lambebop/KiRA/README.md

# KiRA Flight Computer

Flight computer of Karlsruhe International Rocketry Association
