lambebop/KiRA/dep/Wio-SX1262 file.step

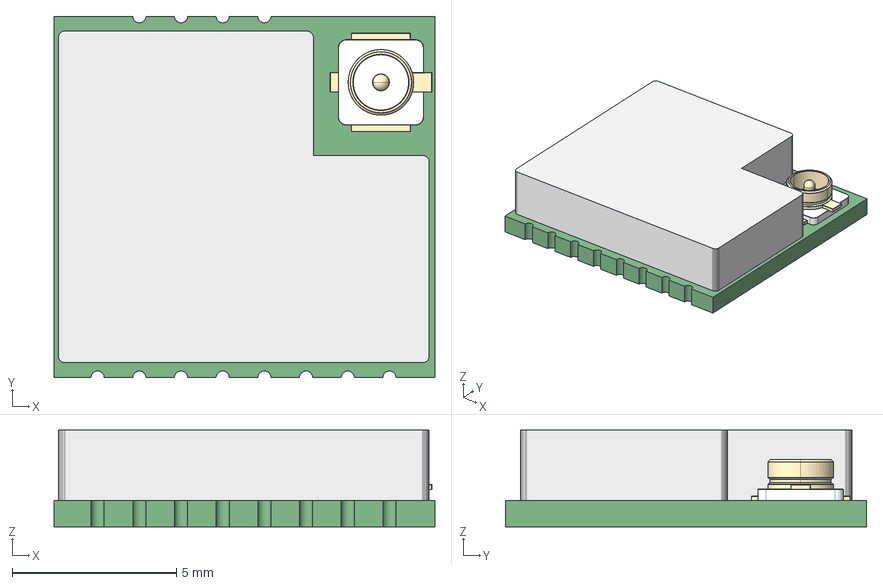
[picture p1: CAD file, 2025-10-07]
dep/Wio-SX1262 file.step
11.6 x 11.0 x 2.95 mm
User_Library-IPEX
Extruded
