lambebop/KiRA/dep/FDMA430NZ.stp

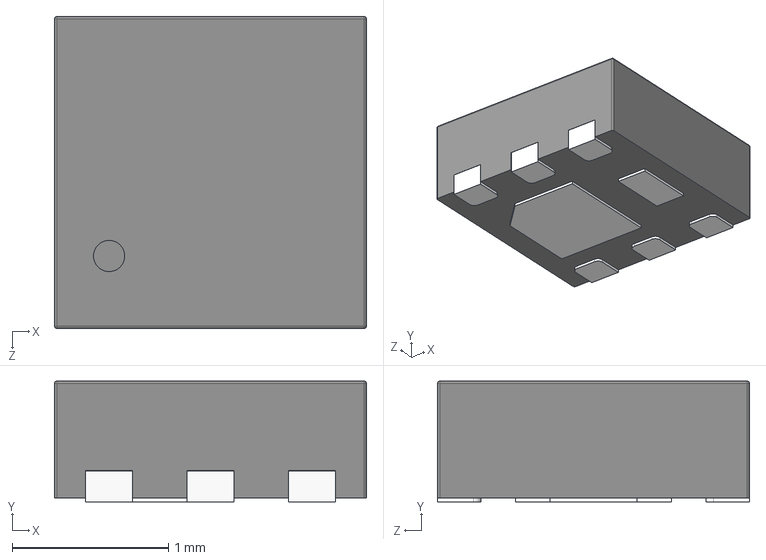
[picture p2: CAD file, 2025-10-07]
dep/FDMA430NZ.stp
2.00 x 0.775 x 2.00 mm
