lambebop/KiRA/dep/CONSMA001-SMD-G.stp

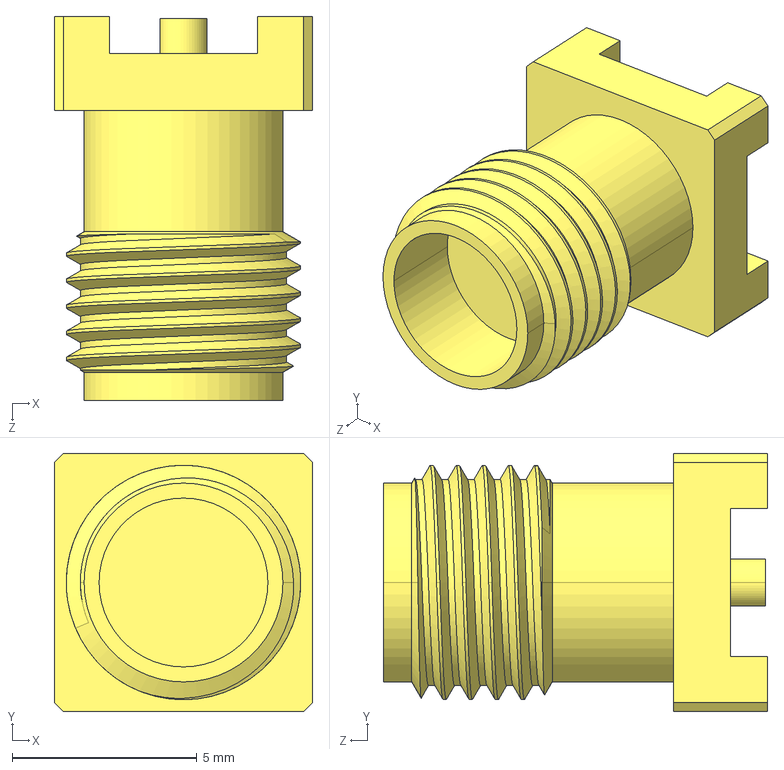
[picture p3: CAD file, 2025-10-07]
dep/CONSMA001-SMD-G.stp
7.00 x 7.00 x 10.4 mm
