lambebop/KiRA/KiRA Flight Computer.kicad_pcb

## KiCad design KiRA Flight Computer.kicad_pcb (2025-10-17)

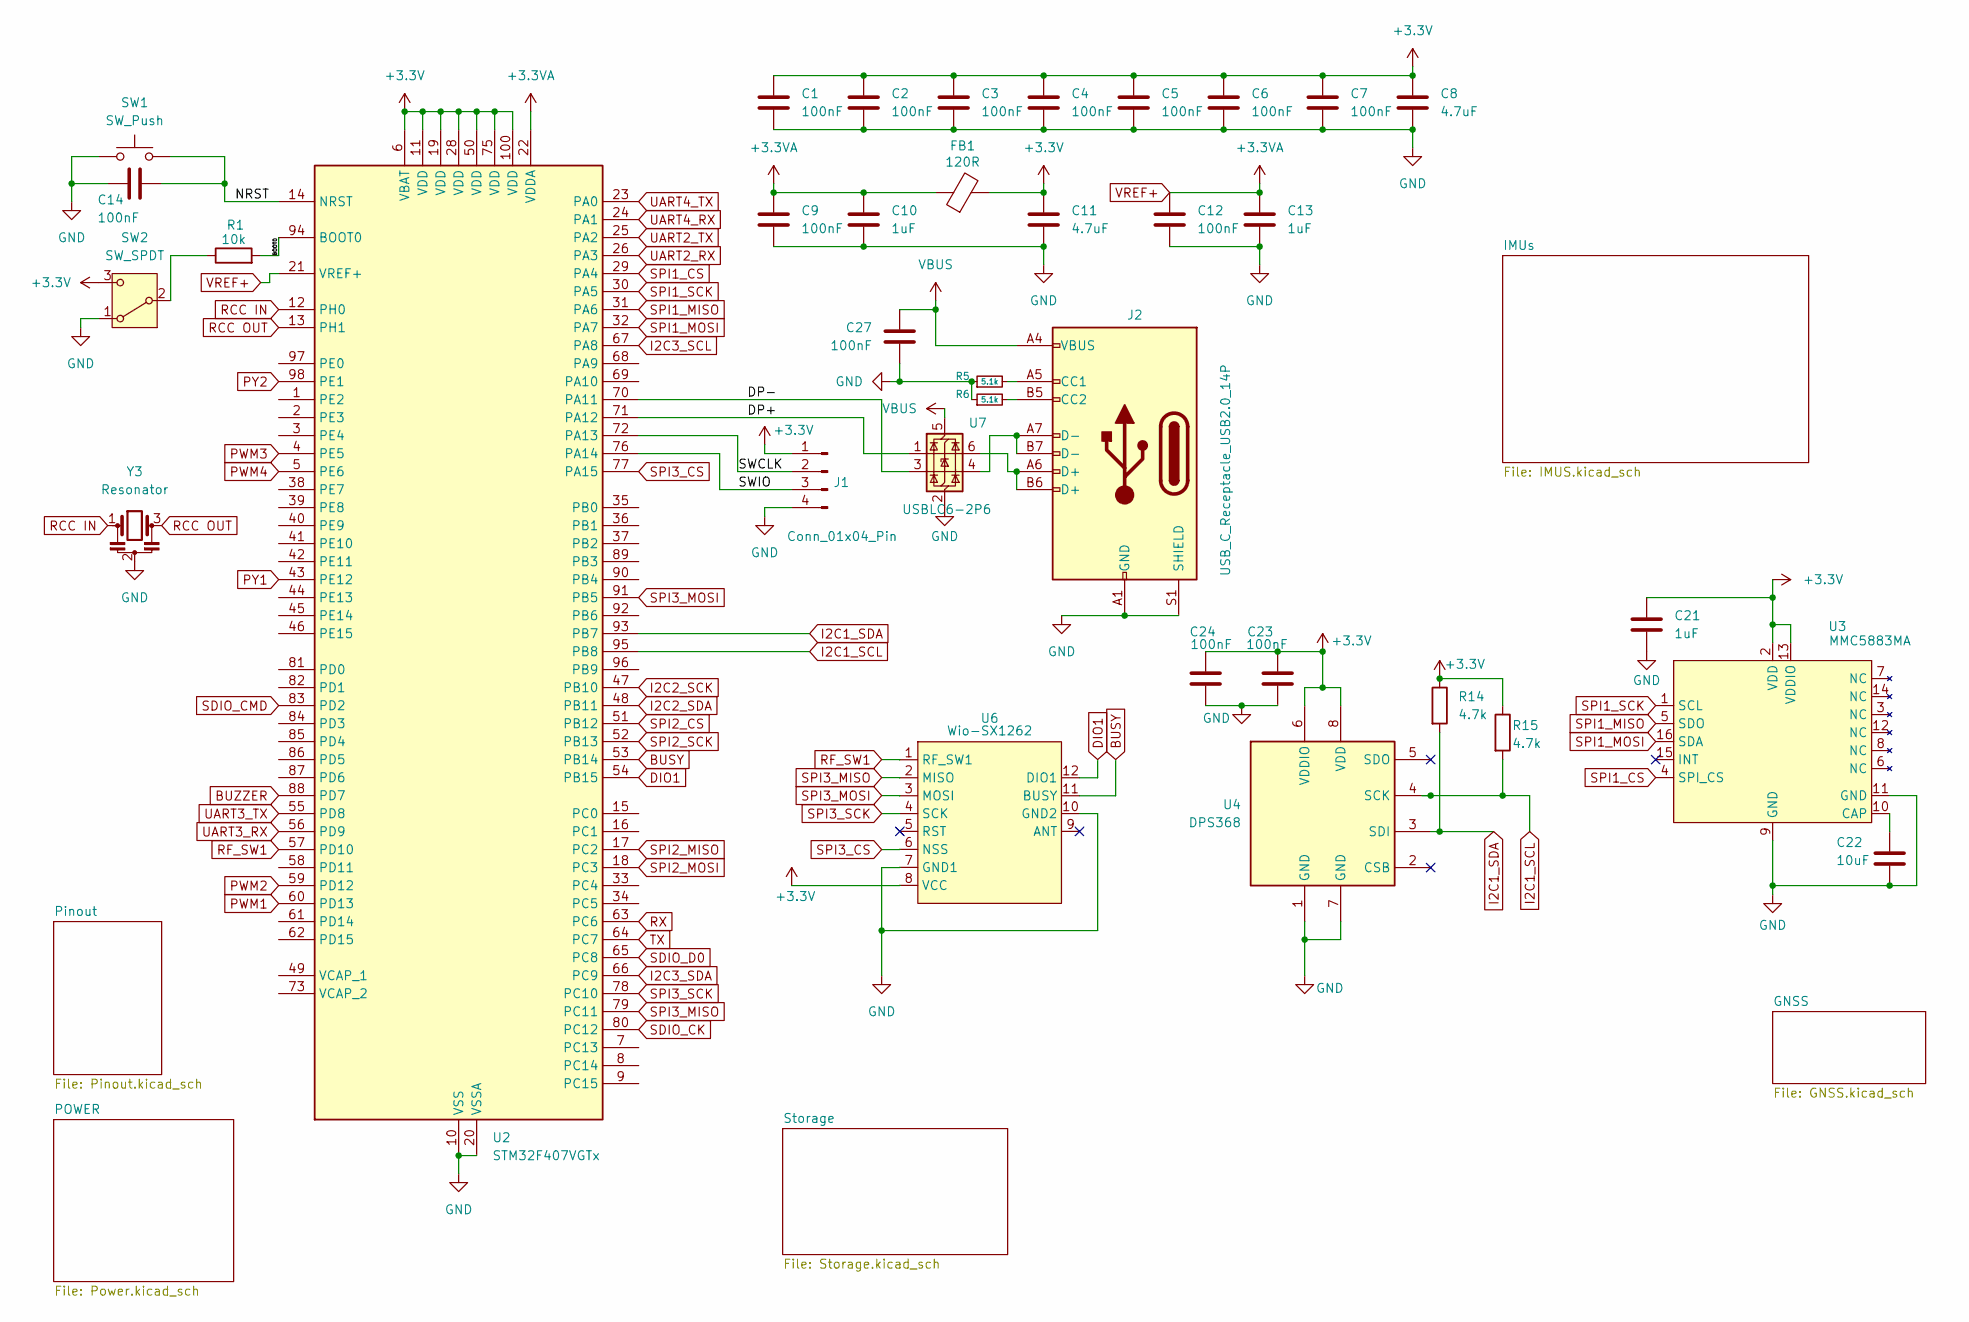
[picture p4: schematic KiRA Flight Computer.kicad_sch]

Parts:
C1, C2, C3, C4, C5, C6, C7, C9, C12, C14, C23, C24: 100nF; C_0603_1608Metric
C8, C11: 4.7uF; C_0603_1608Metric
C10, C13, C21: 1uF; C_0603_1608Metric
C22: 10uF; C_1206_3216Metric
C27: 100nF; C_0402_1005Metric_Pad0.74x0.62mm_HandSolder
FB1: 120R; L_1206_3216Metric
J1: Conn_01x04_Pin; PinHeader_1x04_P2.54mm_Vertical
J2: USB_C_Receptacle_USB2.0_14P; USB_C_Receptacle_GCT_USB4105-xx-A_16P_TopMnt_Horizontal
R1: 10k; R_0603_1608Metric
R5, R6: 5.1k; R_0603_1608Metric
R14, R15: 4.7k; R_0603_1608Metric
SW1: SW_Push; SW_Push_1P1T_NO_CK_KSC6xxJ
SW2: SW_SPDT; SW_SPDT_CK_JS102011SAQN
U2: STM32F407VGTx; LQFP-100_14x14mm_P0.5mm
U3: MMC5883MA; LGA-16_3x3mm_P0.5mm
U4: DPS368; Bosch_LGA-8_2x2.5mm_P0.65mm_ClockwisePinNumbering
U6: Wio-SX1262; WIO SX1262
U7: USBLC6-2P6; SOT-666
Y3: Resonator; Resonator_SMD_Murata_CSTxExxV-3Pin_3.0x1.1mm

Connections:
+3.3V: C1.1, C2.1, C3.1, C4.1, C5.1, C6.1, C7.1, C8.1, C11.1, C21.1, C23.1, C24.1, FB1.2, J1.1, R14.1, R15.1, SW2.3 (C), U2.6 (VBAT), U2.11 (VDD), U2.19 (VDD), U2.28 (VDD), U2.50 (VDD), U2.75 (VDD), U2.100 (VDD), U3.2 (VDD), U3.13 (VDDIO), U4.6 (VDDIO), U4.8 (VDD), U6.8 (VCC); also elsewhere on the board
/BOOT0: R1.2, U2.94 (BOOT0)
/DP+: U2.71 (PA12), U7.1 (I/O1)
/DP-: U2.70 (PA11), U7.3 (I/O2)
/NRST: C14.1, SW1.2, U2.14 (NRST)
/SWCLK: J1.2, U2.72 (PA13)
/SWIO: J1.3, U2.76 (PA14)
BUSY: U2.53 (PB14), U6.11 (BUSY)
BUZZER: U2.88 (PD7); also elsewhere on the board
DIO1: U2.54 (PB15), U6.12 (DIO1)
GND: C1.2, C2.2, C3.2, C4.2, C5.2, C6.2, C7.2, C8.2, C9.2, C10.2, C11.2, C12.2, C13.2, C14.2, C21.2, C22.2, C23.2, C24.2, C27.1, J1.4, J2.A1 (GND), J2.A12 (GND), J2.B1 (GND), J2.B12 (GND), J2.S1 (SHIELD), R5.1, R6.1, SW1.1, SW2.1 (A), U2.10 (VSS), U2.20 (VSSA), U2.27 (VSS), U2.74 (VSS), U2.99 (VSS), U3.9 (GND), U3.11 (GND), U4.1 (GND), U4.7 (GND), U6.7 (GND1), U6.10 (GND2), U7.2 (GND), Y3.2; also elsewhere on the board
I2C1_SCL: R15.2, U2.95 (PB8), U4.4 (SCK)
I2C1_SDA: R14.2, U2.93 (PB7), U4.3 (SDI)
I2C2_SCK: U2.47 (PB10); also elsewhere on the board
I2C2_SDA: U2.48 (PB11); also elsewhere on the board
I2C3_SCL: U2.67 (PA8); also elsewhere on the board
I2C3_SDA: U2.66 (PC9); also elsewhere on the board
unnamed: J2.A5 (CC1), R5.2
unnamed: J2.B5 (CC2), R6.2
unnamed: J2.A6 (D+), J2.B6 (D+), U7.6 (I/O1)
unnamed: J2.A7 (D-), J2.B7 (D-), U7.4 (I/O2)
unnamed: R1.1, SW2.2 (B)
unnamed: C22.1, U3.10 (CAP)
PWM1: U2.60 (PD13); also elsewhere on the board
PWM2: U2.59 (PD12); also elsewhere on the board
PWM3: U2.4 (PE5); also elsewhere on the board
PWM4: U2.5 (PE6); also elsewhere on the board
PY1: U2.43 (PE12); also elsewhere on the board
PY2: U2.98 (PE1); also elsewhere on the board
RCC IN: U2.12 (PH0), Y3.1
RCC OUT: U2.13 (PH1), Y3.3
RF_SW1: U2.57 (PD10), U6.1 (RF_SW1)
RX: U2.63 (PC6); also elsewhere on the board
SDIO_CK: U2.80 (PC12); also elsewhere on the board
SDIO_CMD: U2.83 (PD2); also elsewhere on the board
SDIO_D0: U2.65 (PC8); also elsewhere on the board
SPI1_CS: U2.29 (PA4), U3.4 (SPI_CS)
SPI1_MISO: U2.31 (PA6), U3.5 (SDO)
SPI1_MOSI: U2.32 (PA7), U3.16 (SDA)
SPI1_SCK: U2.30 (PA5), U3.1 (SCL)
SPI2_CS: U2.51 (PB12); also elsewhere on the board
SPI2_MISO: U2.17 (PC2); also elsewhere on the board
SPI2_MOSI: U2.18 (PC3); also elsewhere on the board
SPI2_SCK: U2.52 (PB13); also elsewhere on the board
SPI3_CS: U2.77 (PA15), U6.6 (NSS)
SPI3_MISO: U2.79 (PC11), U6.2 (MISO)
SPI3_MOSI: U2.91 (PB5), U6.3 (MOSI)
SPI3_SCK: U2.78 (PC10), U6.4 (SCK)
TX: U2.64 (PC7); also elsewhere on the board
UART2_RX: U2.26 (PA3)
UART2_TX: U2.25 (PA2)
UART3_RX: U2.56 (PD9); also elsewhere on the board
UART3_TX: U2.55 (PD8); also elsewhere on the board
UART4_RX: U2.24 (PA1); also elsewhere on the board
UART4_TX: U2.23 (PA0); also elsewhere on the board
VBUS: C27.2, J2.A4 (VBUS), J2.A9 (VBUS), J2.B4 (VBUS), J2.B9 (VBUS), U7.5 (VBUS); also elsewhere on the board
VREF+: C9.1, C10.1, C12.1, C13.1, FB1.1, U2.21 (VREF+), U2.22 (VDDA)

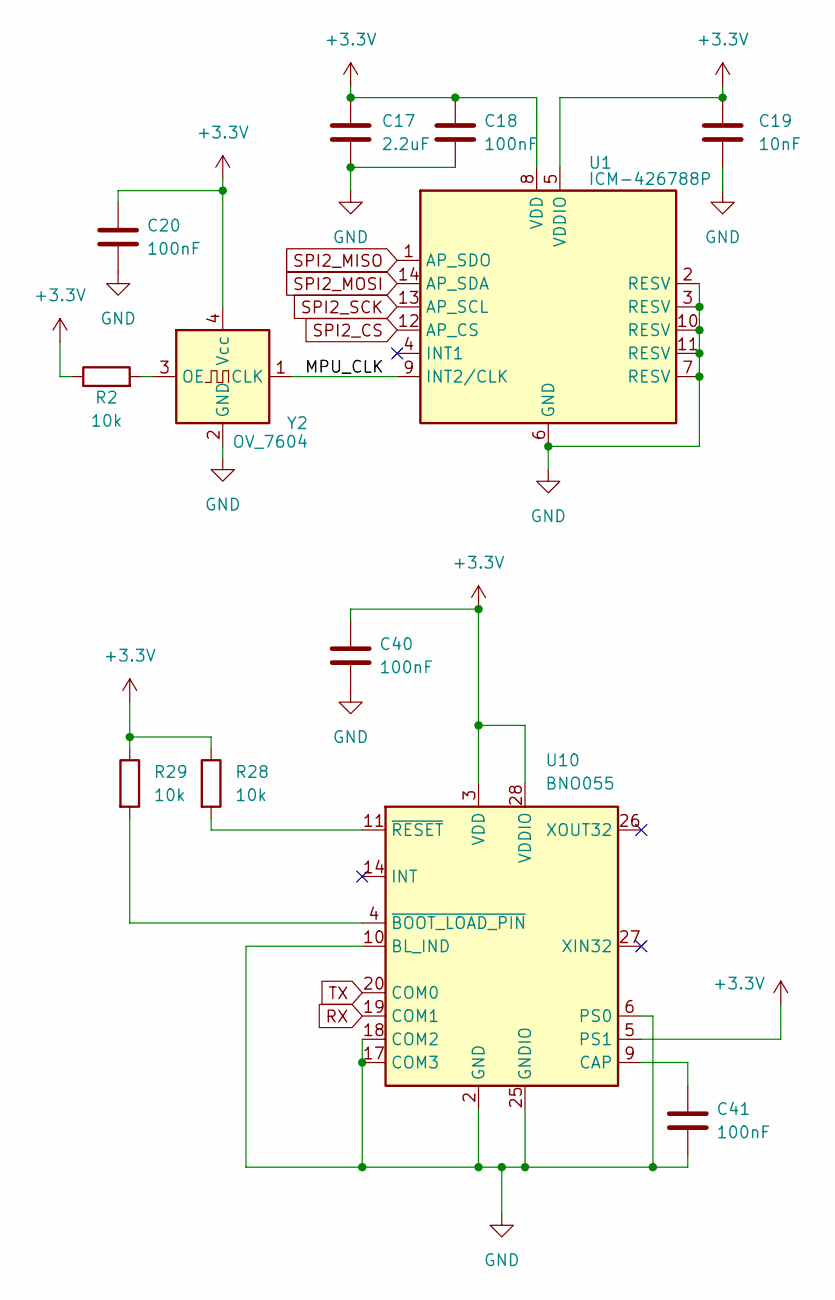
[picture p5: schematic IMUS.kicad_sch]

Parts:
C17: 2.2uF; C_0603_1608Metric
C18, C20, C40, C41: 100nF; C_0603_1608Metric
C19: 10nF; C_0603_1608Metric
R2, R28, R29: 10k; R_0603_1608Metric
U1: ICM-426788P; Bosch_LGA-14_3x2.5mm_P0.5mm
U10: BNO055; LGA-28_5.2x3.8mm_P0.5mm
Y2: OV_7604; Oscillator_SMD_SeikoEpson_SG3030CM

Connections:
+3.3V: C17.1, C18.1, C19.1, C20.1, C40.1, R2.1, R28.1, R29.1, U1.5 (VDDIO), U1.8 (VDD), U10.3 (VDD), U10.5 (PS1), U10.28 (VDDIO), Y2.4 (Vcc); also elsewhere on the board
/IMUs/MPU_CLK: U1.9 (INT2/CLK), Y2.1 (CLK)
GND: C17.2, C18.2, C19.2, C20.2, C40.2, C41.2, U1.2 (RESV), U1.3 (RESV), U1.6 (GND), U1.7 (RESV), U1.10 (RESV), U1.11 (RESV), U10.2 (GND), U10.6 (PS0), U10.10 (BL_IND), U10.17 (COM3), U10.18 (COM2), U10.25 (GNDIO), Y2.2 (GND); also elsewhere on the board
unnamed: C41.1, U10.9 (CAP)
unnamed: R29.2, U10.4 (~BOOT_LOAD_PIN)
unnamed: R28.2, U10.11 (~RESET)
unnamed: R2.2, Y2.3 (OE)
RX: U10.19 (COM1); also elsewhere on the board
SPI2_CS: U1.12 (AP_CS); also elsewhere on the board
SPI2_MISO: U1.1 (AP_SDO); also elsewhere on the board
SPI2_MOSI: U1.14 (AP_SDA); also elsewhere on the board
SPI2_SCK: U1.13 (AP_SCL); also elsewhere on the board
TX: U10.20 (COM0); also elsewhere on the board

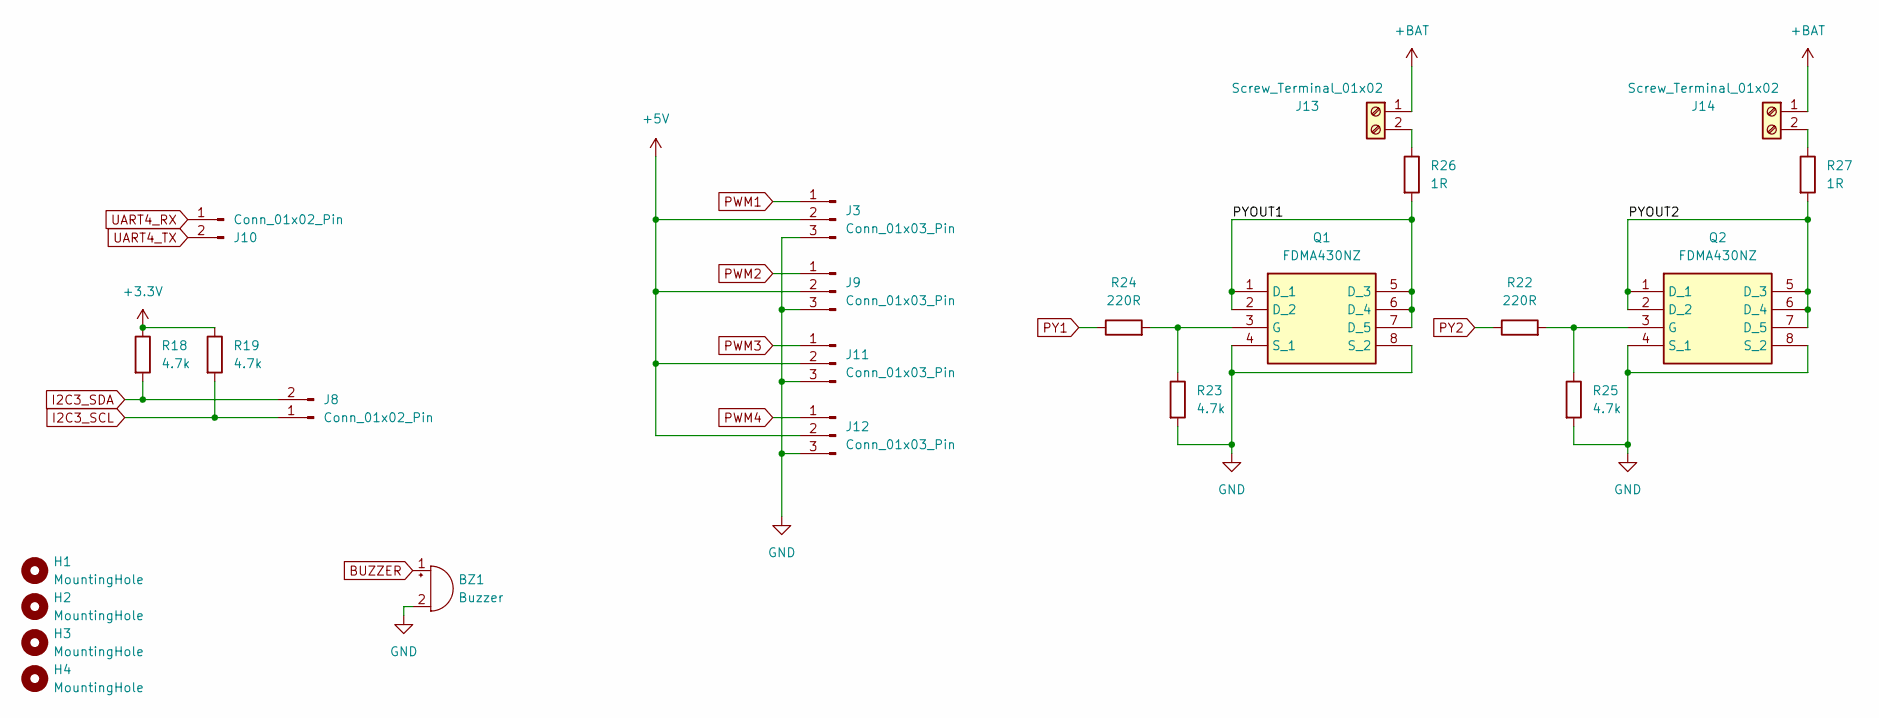
[picture p6: schematic Pinout.kicad_sch]

Parts:
BZ1: Buzzer; Buzzer_CUI_CPT-9019S-SMT
H1, H2, H3, H4: MountingHole; MountingHole_2.2mm_M2_DIN965_Pad
J3, J9, J11, J12: Conn_01x03_Pin; PinHeader_1x03_P2.54mm_Vertical
J8, J10: Conn_01x02_Pin; PinHeader_1x02_P2.54mm_Vertical
J13, J14: Screw_Terminal_01x02; TerminalBlock_Phoenix_MPT-0,5-2-2.54_1x02_P2.54mm_Horizontal
Q1, Q2: FDMA430NZ; Mouser Part Number 512-FDMA430NZ
R18, R19, R23, R25: 4.7k; R_0603_1608Metric
R22, R24: 220R; R_0402_1005Metric
R26, R27: 1R; R_0603_1608Metric

Connections:
+3.3V: R18.1, R19.1; also elsewhere on the board
+5V: J3.2, J9.2, J11.2, J12.2; also elsewhere on the board
+BAT: J13.1, J14.1; also elsewhere on the board
/Pinout/PYOUT1: Q1.1 (D_1), Q1.2 (D_2), Q1.5 (D_3), Q1.6 (D_4), Q1.7 (D_5), R26.2
/Pinout/PYOUT2: Q2.1 (D_1), Q2.2 (D_2), Q2.5 (D_3), Q2.6 (D_4), Q2.7 (D_5), R27.2
BUZZER: BZ1.1 (+); also elsewhere on the board
GND: BZ1.2 (-), J3.3, J9.3, J11.3, J12.3, Q1.4 (S_1), Q1.8 (S_2), Q2.4 (S_1), Q2.8 (S_2), R23.2, R25.2; also elsewhere on the board
I2C3_SCL: J8.1, R19.2; also elsewhere on the board
I2C3_SDA: J8.2, R18.2; also elsewhere on the board
unnamed: J13.2, R26.1
unnamed: J14.2, R27.1
unnamed: Q1.3 (G), R23.1, R24.2
unnamed: Q2.3 (G), R22.2, R25.1
PWM1: J3.1; also elsewhere on the board
PWM2: J9.1; also elsewhere on the board
PWM3: J11.1; also elsewhere on the board
PWM4: J12.1; also elsewhere on the board
PY1: R24.1; also elsewhere on the board
PY2: R22.1; also elsewhere on the board
UART4_RX: J10.1; also elsewhere on the board
UART4_TX: J10.2; also elsewhere on the board

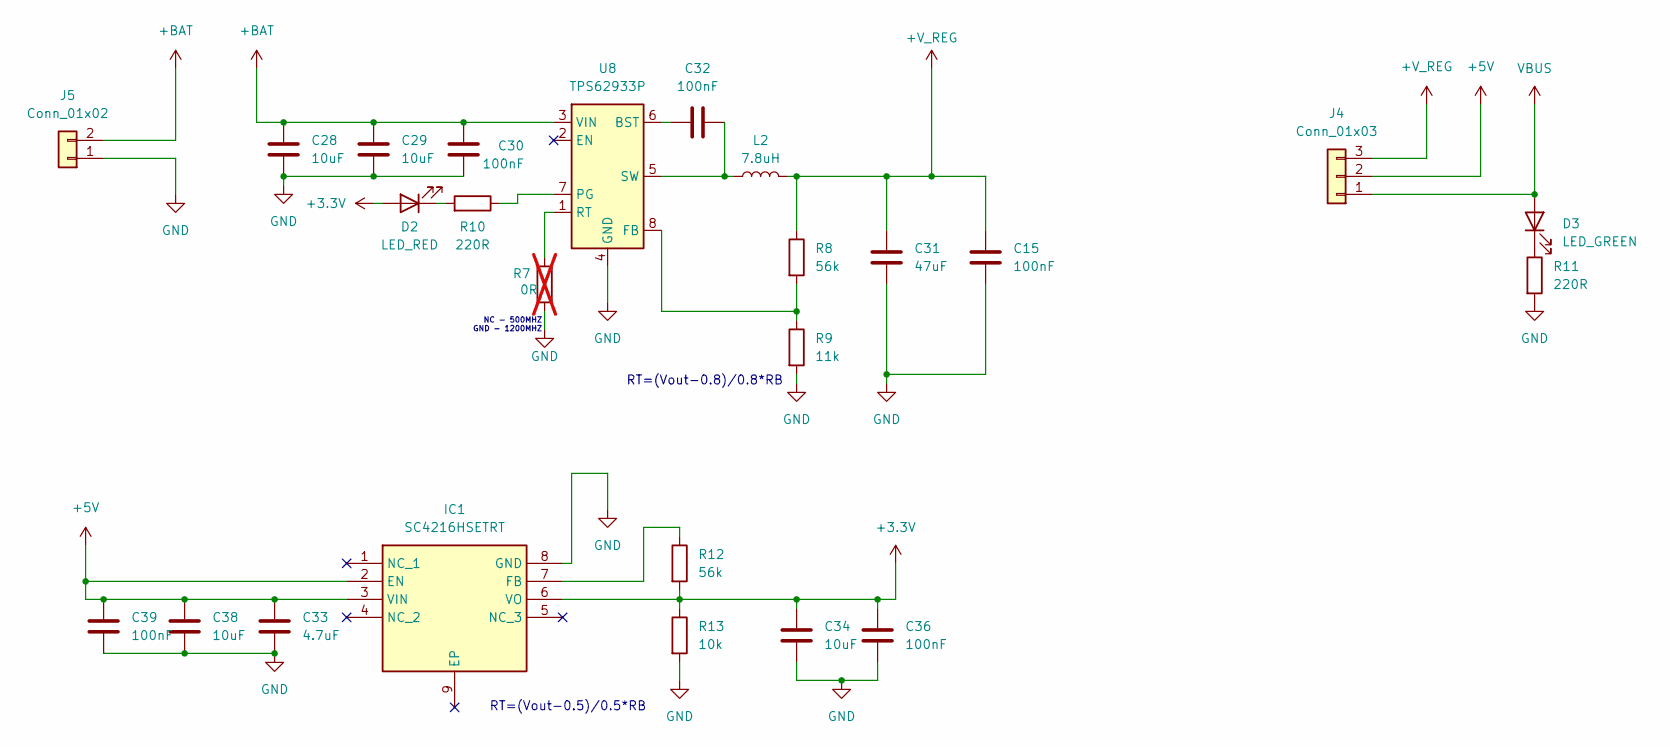
[picture p7: schematic Power.kicad_sch]

Parts:
C15, C30, C32, C36, C39: 100nF; C_0603_1608Metric
C28, C29, C34, C38: 10uF; C_1206_3216Metric
C31: 47uF; C_1210_3225Metric
C33: 4.7uF; C_0603_1608Metric
D2: LED_RED; LED_0603_1608Metric
D3: LED_GREEN; LED_0603_1608Metric
IC1: SC4216HSETRT; SOIC127P600X175-9N; Mouser Part Number 947-SC4216HSETRT
J4: Conn_01x03; PinSocket_1x03_P2.54mm_Vertical
J5: Conn_01x02; AMASS_XT30U-F_1x02_P5.0mm_Vertical
L2: 7.8uH; L_APV_APH1050
R7: 0R; R_0603_1608Metric; not fitted
R8, R12: 56k; R_0805_2012Metric
R9: 11k; R_0603_1608Metric
R10, R11: 220R; R_0402_1005Metric
R13: 10k; R_0603_1608Metric
U8: TPS62933P; SOT-583-8

Connections:
+3.3V: C34.1, C36.1, D2.2 (A), IC1.6 (VO), R12.2, R13.1; also elsewhere on the board
+5V: C33.1, C38.1, C39.1, IC1.2 (EN), IC1.3 (VIN), J4.2; also elsewhere on the board
+BAT: C28.1, C29.1, C30.1, J5.2, U8.3 (VIN); also elsewhere on the board
+V_REG: C15.1, C31.1, J4.3, L2.2, R8.1
GND: C15.2, C28.2, C29.2, C30.2, C31.2, C33.2, C34.2, C36.2, C38.2, C39.2, IC1.8 (GND), J5.1, R7.2, R9.2, R11.2, R13.2, U8.4 (GND); also elsewhere on the board
unnamed: D2.1 (K), R10.2
unnamed: D3.1 (K), R11.1
unnamed: IC1.7 (FB), R12.1
unnamed: C32.1, U8.6 (BST)
unnamed: R8.2, R9.1, U8.8 (FB)
unnamed: R10.1, U8.7 (PG)
unnamed: R7.1, U8.1 (RT)
unnamed: C32.2, L2.1, U8.5 (SW)
VBUS: D3.2 (A), J4.1; also elsewhere on the board

Notes on the sheet:
RT=(Vout-0.5)/0.5*RB
NC - 500MHZ GND - 1200MHZ
RT=(Vout-0.8)/0.8*RB

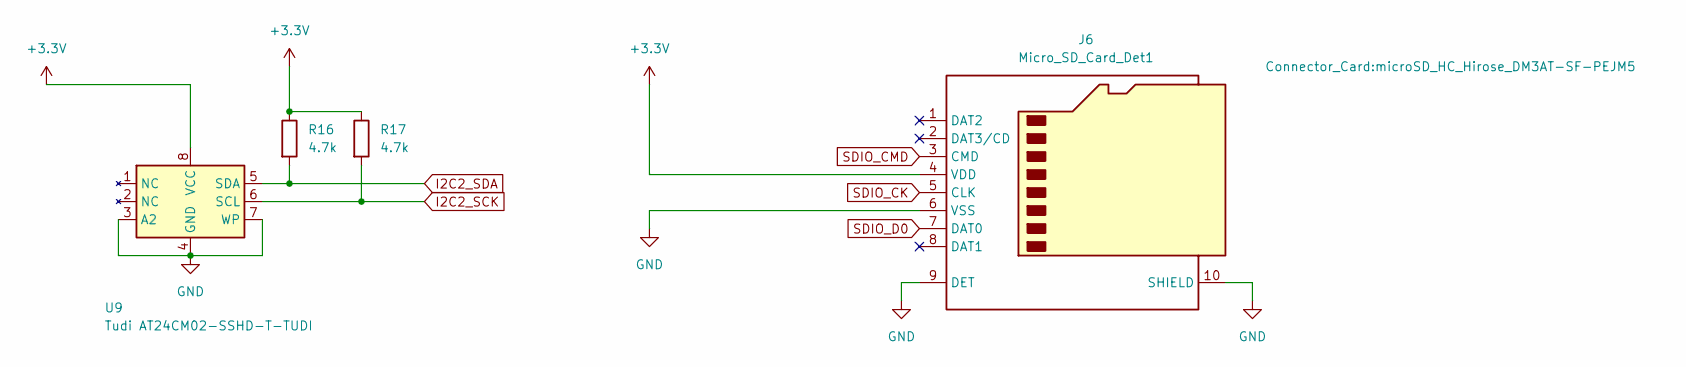
[picture p8: schematic Storage.kicad_sch]

Parts:
J6: Micro_SD_Card_Det1; microSD_HC_Hirose_DM3AT-SF-PEJM5
R16, R17: 4.7k; R_0603_1608Metric
U9: Tudi AT24CM02-SSHD-T-TUDI; SOIC-8_3.9x4.9mm_P1.27mm

Connections:
+3.3V: J6.4 (VDD), R16.1, R17.1, U9.8 (VCC); also elsewhere on the board
GND: J6.6 (VSS), J6.9 (DET), J6.10 (SHIELD), U9.3 (A2), U9.4 (GND), U9.7 (WP); also elsewhere on the board
I2C2_SCK: R17.2, U9.6 (SCL); also elsewhere on the board
I2C2_SDA: R16.2, U9.5 (SDA); also elsewhere on the board
SDIO_CK: J6.5 (CLK); also elsewhere on the board
SDIO_CMD: J6.3 (CMD); also elsewhere on the board
SDIO_D0: J6.7 (DAT0); also elsewhere on the board

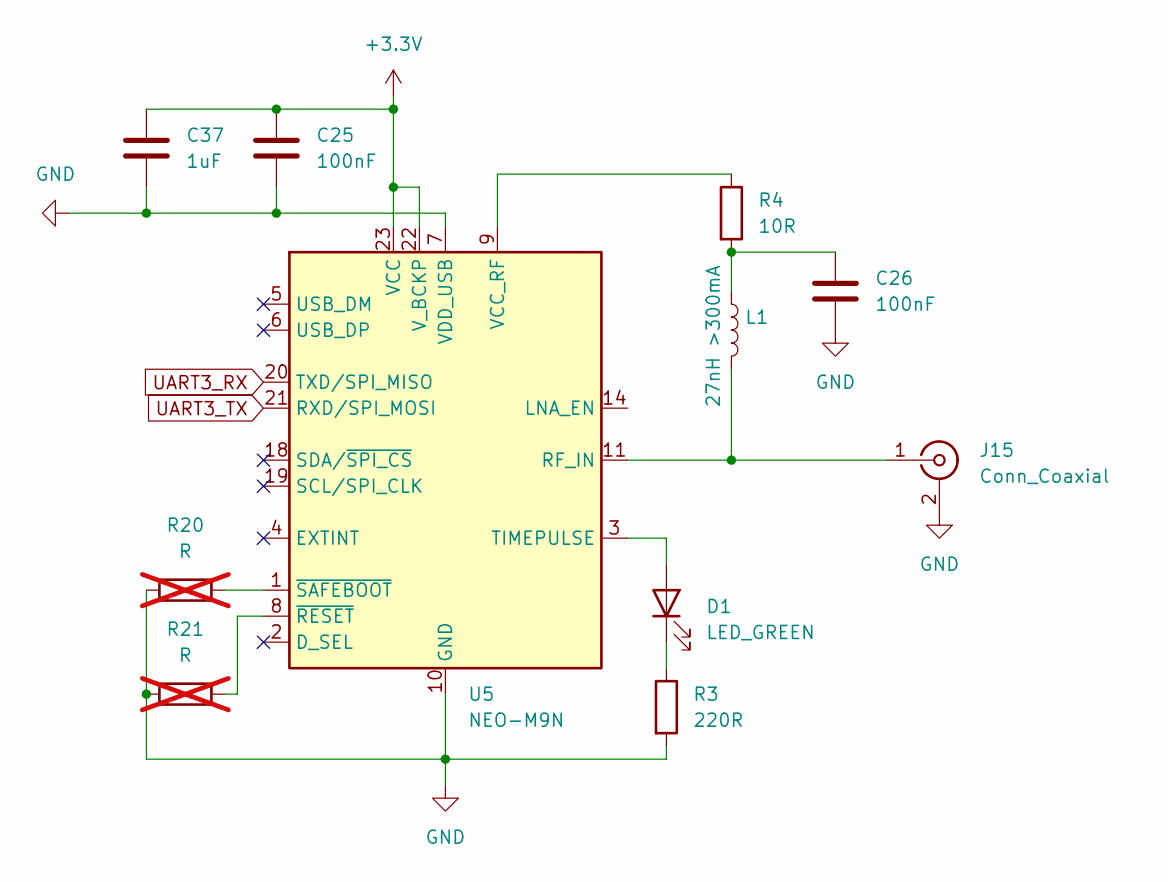
[picture p9: schematic GNSS.kicad_sch]

Parts:
C25, C26: 100nF; C_0603_1608Metric
C37: 1uF; C_0603_1608Metric
D1: LED_GREEN; LED_0603_1608Metric
J15: Conn_Coaxial; U.FL_Hirose_U.FL-R-SMT-1_Vertical
L1: 27nH >300mA; L_0603_1608Metric
R3: 220R; R_0402_1005Metric
R4: 10R; R_0603_1608Metric
R20, R21: R; R_0402_1005Metric; not fitted
U5: NEO-M9N; ublox_NEO

Connections:
+3.3V: C25.1, C37.1, U5.22 (V_BCKP), U5.23 (VCC); also elsewhere on the board
GND: C25.2, C26.2, C37.2, J15.2 (Ext), R3.2, R20.2, R21.2, U5.7 (VDD_USB), U5.10 (GND), U5.12 (GND), U5.13 (GND), U5.24 (GND); also elsewhere on the board
unnamed: C26.1, L1.1, R4.2
unnamed: D1.2 (A), U5.3 (TIMEPULSE)
unnamed: D1.1 (K), R3.1
unnamed: J15.1 (In), L1.2, U5.11 (RF_IN)
unnamed: R4.1, U5.9 (VCC_RF)
unnamed: R21.1, U5.8 (~RESET)
unnamed: R20.1, U5.1 (~SAFEBOOT)
UART3_RX: U5.20 (TXD/SPI_MISO); also elsewhere on the board
UART3_TX: U5.21 (RXD/SPI_MOSI); also elsewhere on the board

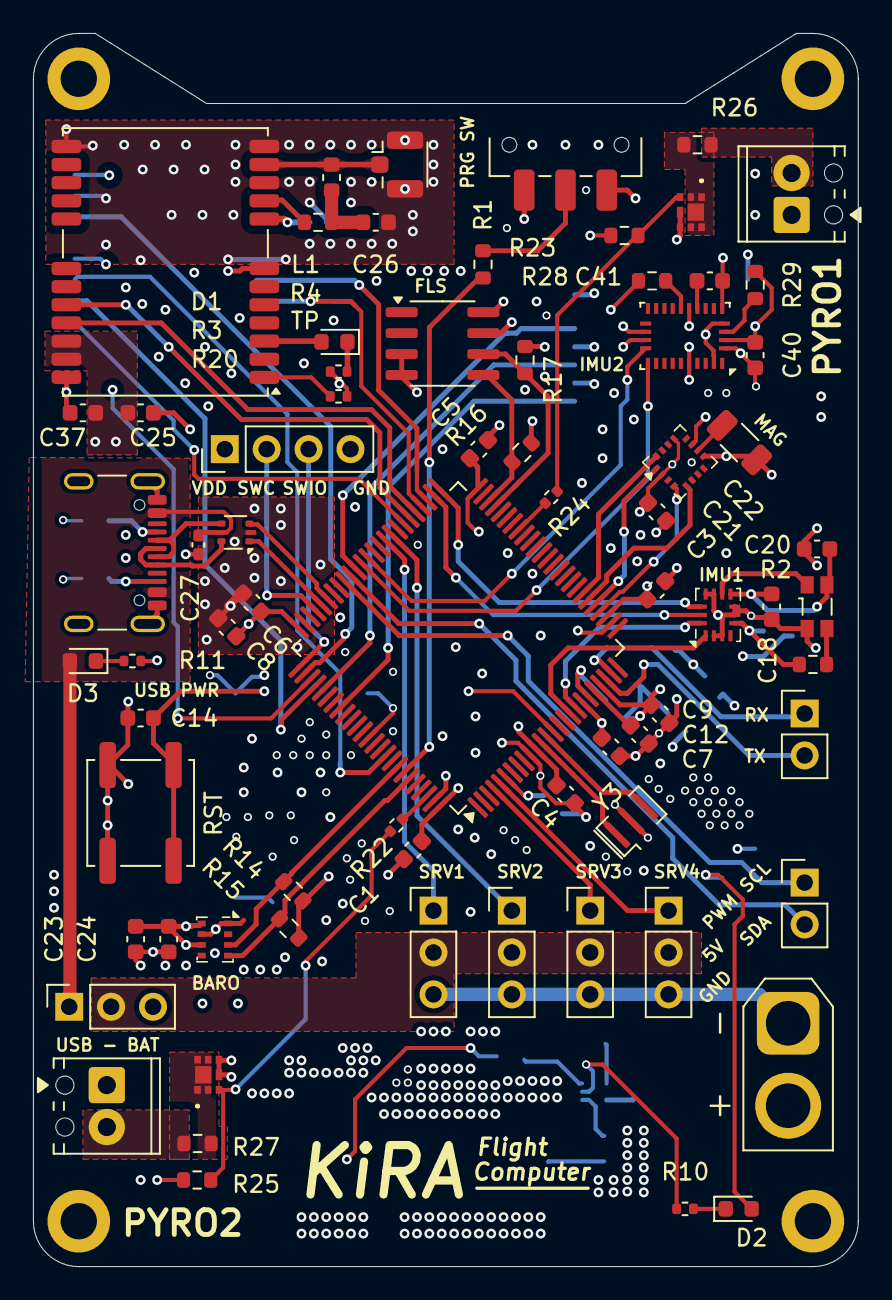
[picture p10: board KiRA Flight Computer.kicad_pcb from above]

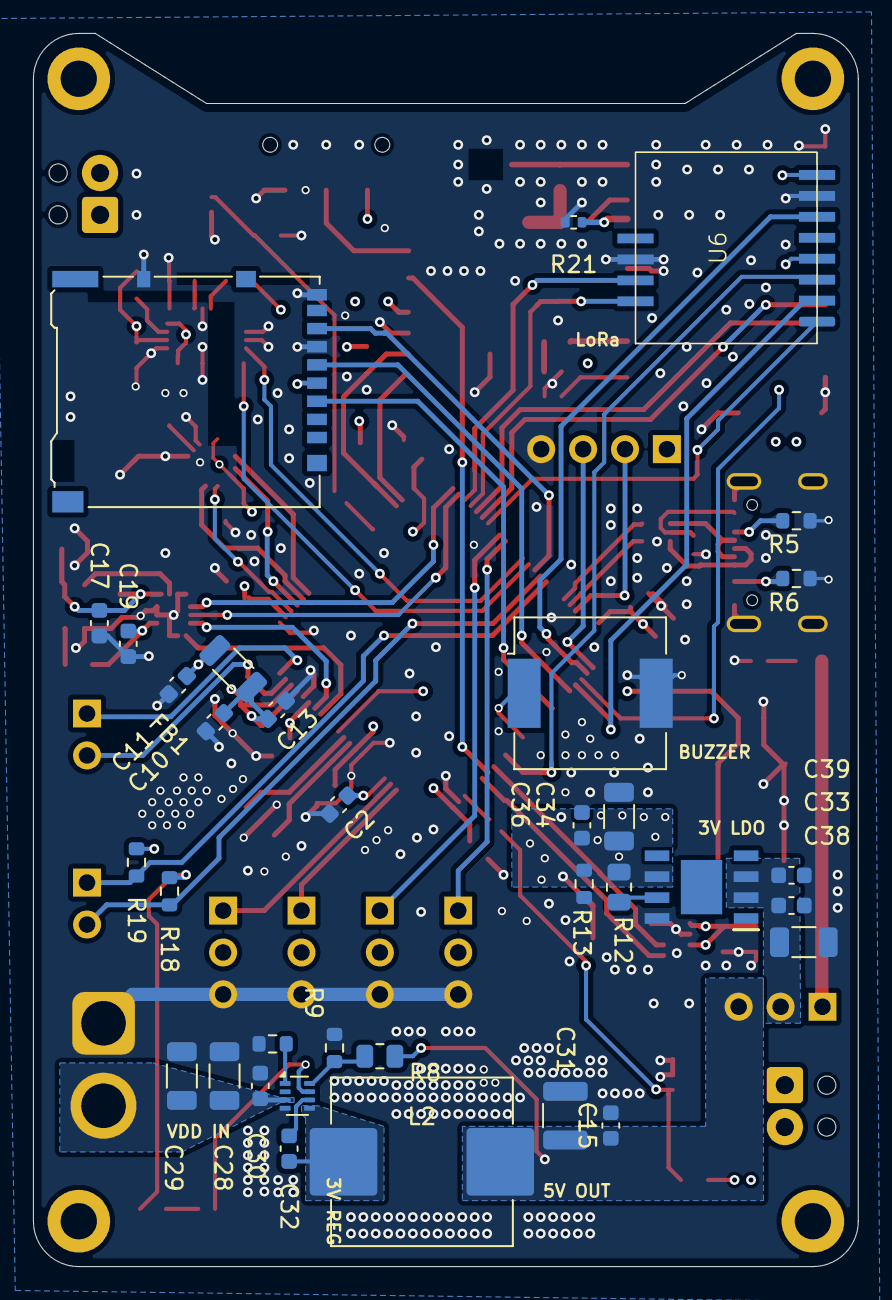
[picture p11: board KiRA Flight Computer.kicad_pcb from below]

Board: 4 copper layers, 50.0 x 74.8 mm, 110 parts (34 on the bottom side), 84 nets.
