lambebop/KiRA/(commit log)

2025-09-21 add sd card reader
    [GNSS.kicad_sch, KiRA Flight Computer.csv, KiRA Flight Computer.kicad_sch, Pinout.kicad_sch, Power.kicad_sch, Storage.kicad_sch]
2025-09-29 "Update KiRA Flight Computer schematic and PCB files"
    [GNSS.kicad_sch, KiRA Flight Computer.csv, KiRA Flight Computer.kicad_pcb, KiRA Flight Computer.kicad_sch, Pinout.kicad_sch, Power.kicad_sch, Storage.kicad_sch]
2025-09-30 Update PCB
    [GNSS.kicad_sch, KiRA Flight Computer.csv, KiRA Flight Computer.kicad_pcb, KiRA Flight Computer.kicad_sch, Power.kicad_sch]
2025-10-05 questionable changes
    [GNSS.kicad_sch, KiRA Flight Computer.kicad_pcb, KiRA Flight Computer.kicad_sch, Pinout.kicad_sch]
2025-10-06 PCB Update
    [GNSS.kicad_sch, KiRA Flight Computer.kicad_pcb, KiRA Flight Computer.kicad_sch, Pinout.kicad_sch, Power.kicad_sch]
2025-10-07 Silkscreen update
    [KiRA Flight Computer.kicad_pcb]
2025-10-07 add dep
    [KiRA Flight Computer.kicad_pcb]
2025-10-17 Update Formulars
    [KiRA Flight Computer.csv, KiRA Flight Computer.kicad_pcb, Power.kicad_sch]
